LC-02s/CL70_Keyboard/Housing/References/TadPole_Mount_1.png

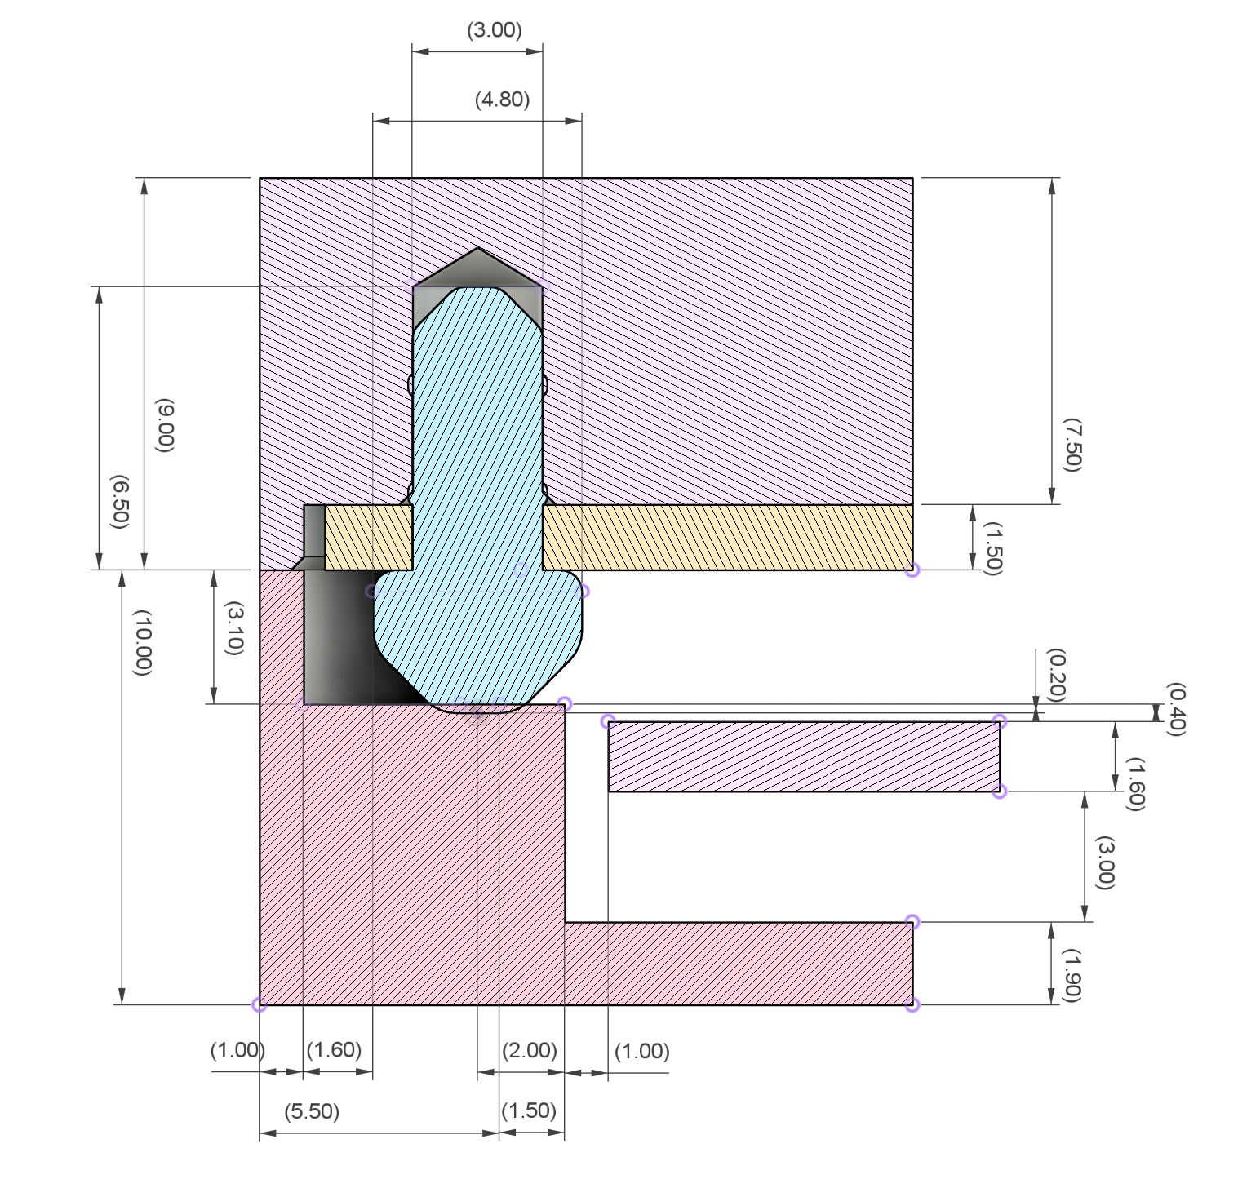
Housing/References/TadPole_Mount_1.png
