LC-02s/CL70_Keyboard/Layout/3u-split-layout.png

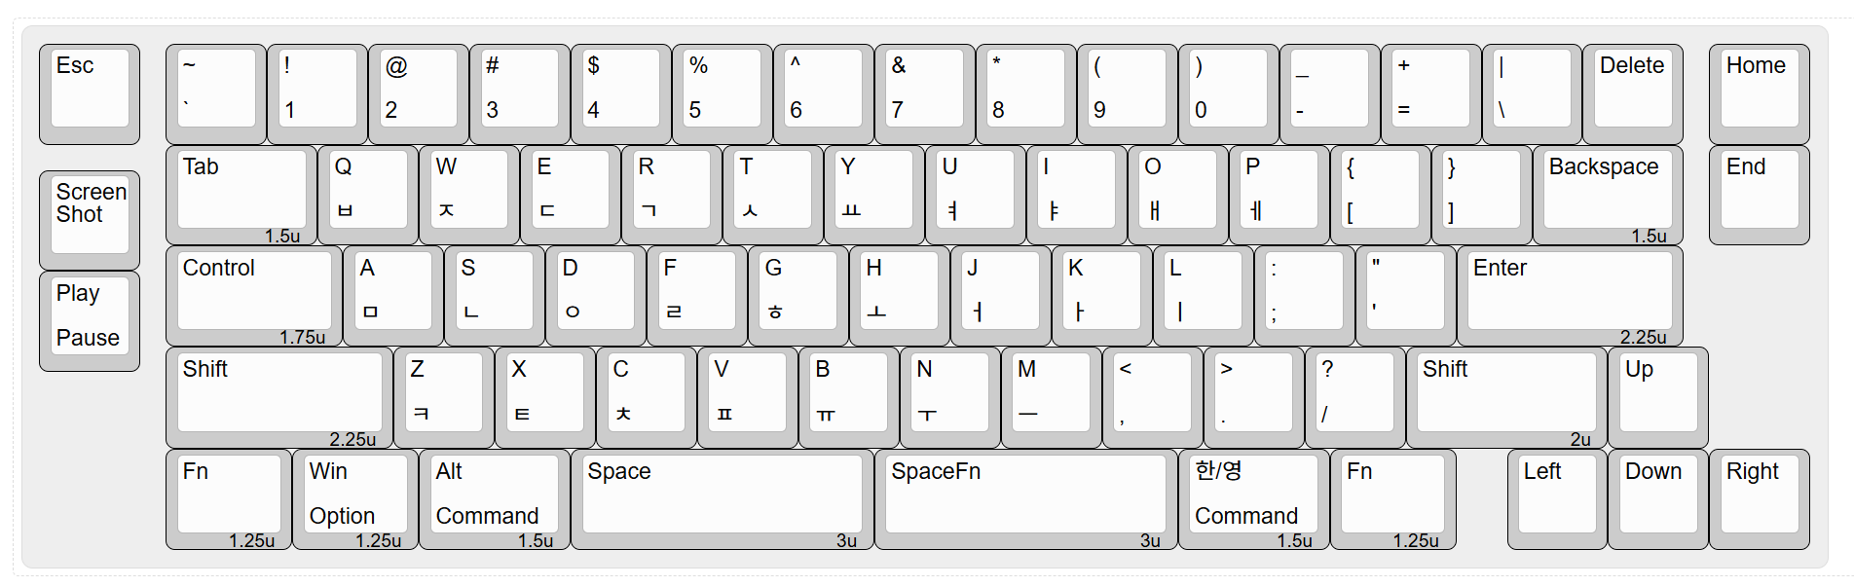
Layout/3u-split-layout.png
