LC-02s/CL70_Keyboard/Layout/6u-layout.png

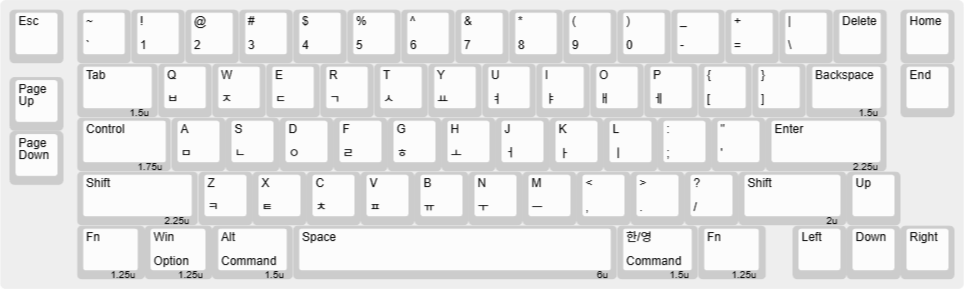
Layout/6u-layout.png
