LC-02s/CL70_Keyboard/Housing/CL70_BottomCase_V2_NonWeight.step

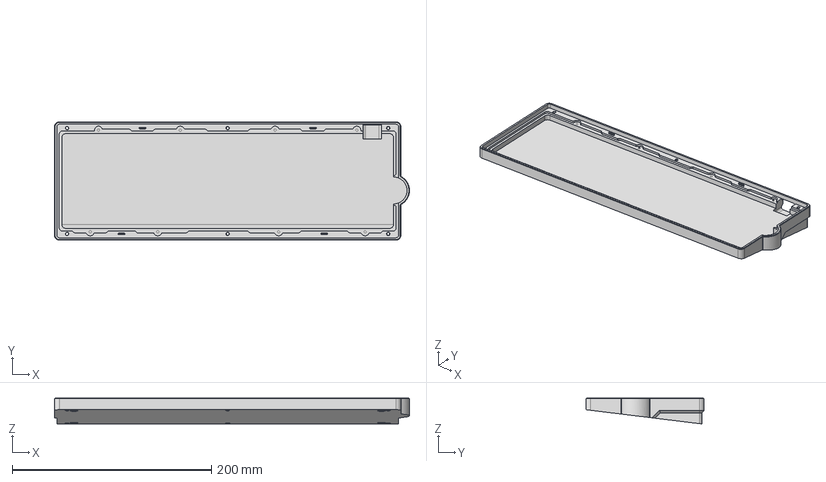
[picture p5: CAD file, 2025-09-10]
Housing/CL70_BottomCase_V2_NonWeight.step
356.7 x 118.9 x 26.0 mm
