LC-02s/CL70_Keyboard/PCB/Guide/PCB_GUIDELINE.dxf

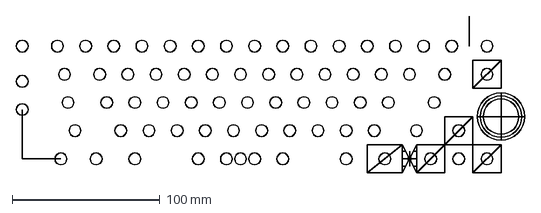
[picture p6: CAD file, 2025-09-10]
PCB/Guide/PCB_GUIDELINE.dxf
343.9 x 106.1 mm
