LC-02s/CL70_Keyboard/Plate/CL70_Plate_3u_Split.dxf

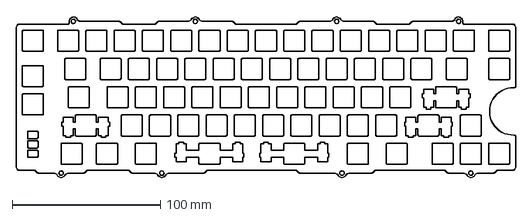
[picture p7: CAD file, 2025-09-10]
Plate/CL70_Plate_3u_Split.dxf
336.5 x 108.5 mm
