LC-02s/CL70_Keyboard/Housing/CL70_TopCase_V2_TappedHole.step

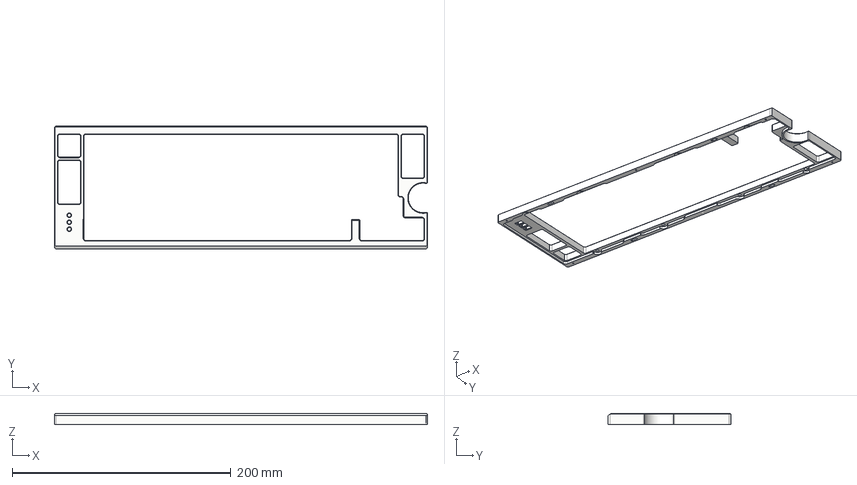
[picture p8: CAD file, 2025-09-10]
Housing/CL70_TopCase_V2_TappedHole.step
341.4 x 112.3 x 10.0 mm
