LC-02s/CL70_Keyboard/PCB/Guide/PCB_OUTLINE.dxf

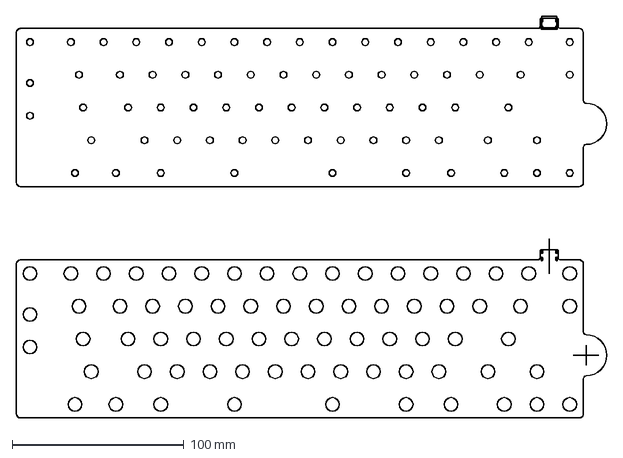
[picture p9: CAD file, 2025-09-10]
PCB/Guide/PCB_OUTLINE.dxf
343.8 x 234.1 mm
