LC-02s/CL70_Keyboard/Plate/CL70_Plate_6u.dxf

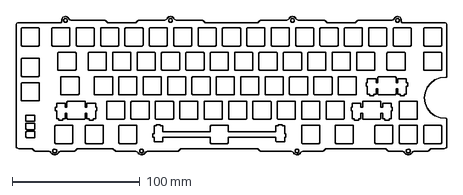
[picture p10: CAD file, 2025-09-10]
Plate/CL70_Plate_6u.dxf
336.5 x 108.5 mm
