LC-02s/CL70_Keyboard/(list of files, cad)

Other CAD files:
Housing/CL70_BottomCase_V2_InsertNuts.step
Housing/CL70_TopCase_V2.step
Housing/CL70_BottomCase_V2.step
Housing/References/FROG_TKL_PIN_TOP.f3d
Housing/References/SQUARE_ROUND_20mm_FEET.f3d
PCB/Guide/PCB_GUIDELINE.dwg
PCB/Guide/PCB_OUTLINE.dwg
Plate/CL70_Plate_3u_Split.dwg
Plate/CL70_Plate_6u.dwg
