LC-02s/CL70_Keyboard/PCB/CL70_PCB.kicad_pcb

## KiCad design PCB/CL70_PCB.kicad_pcb (2025-09-10)

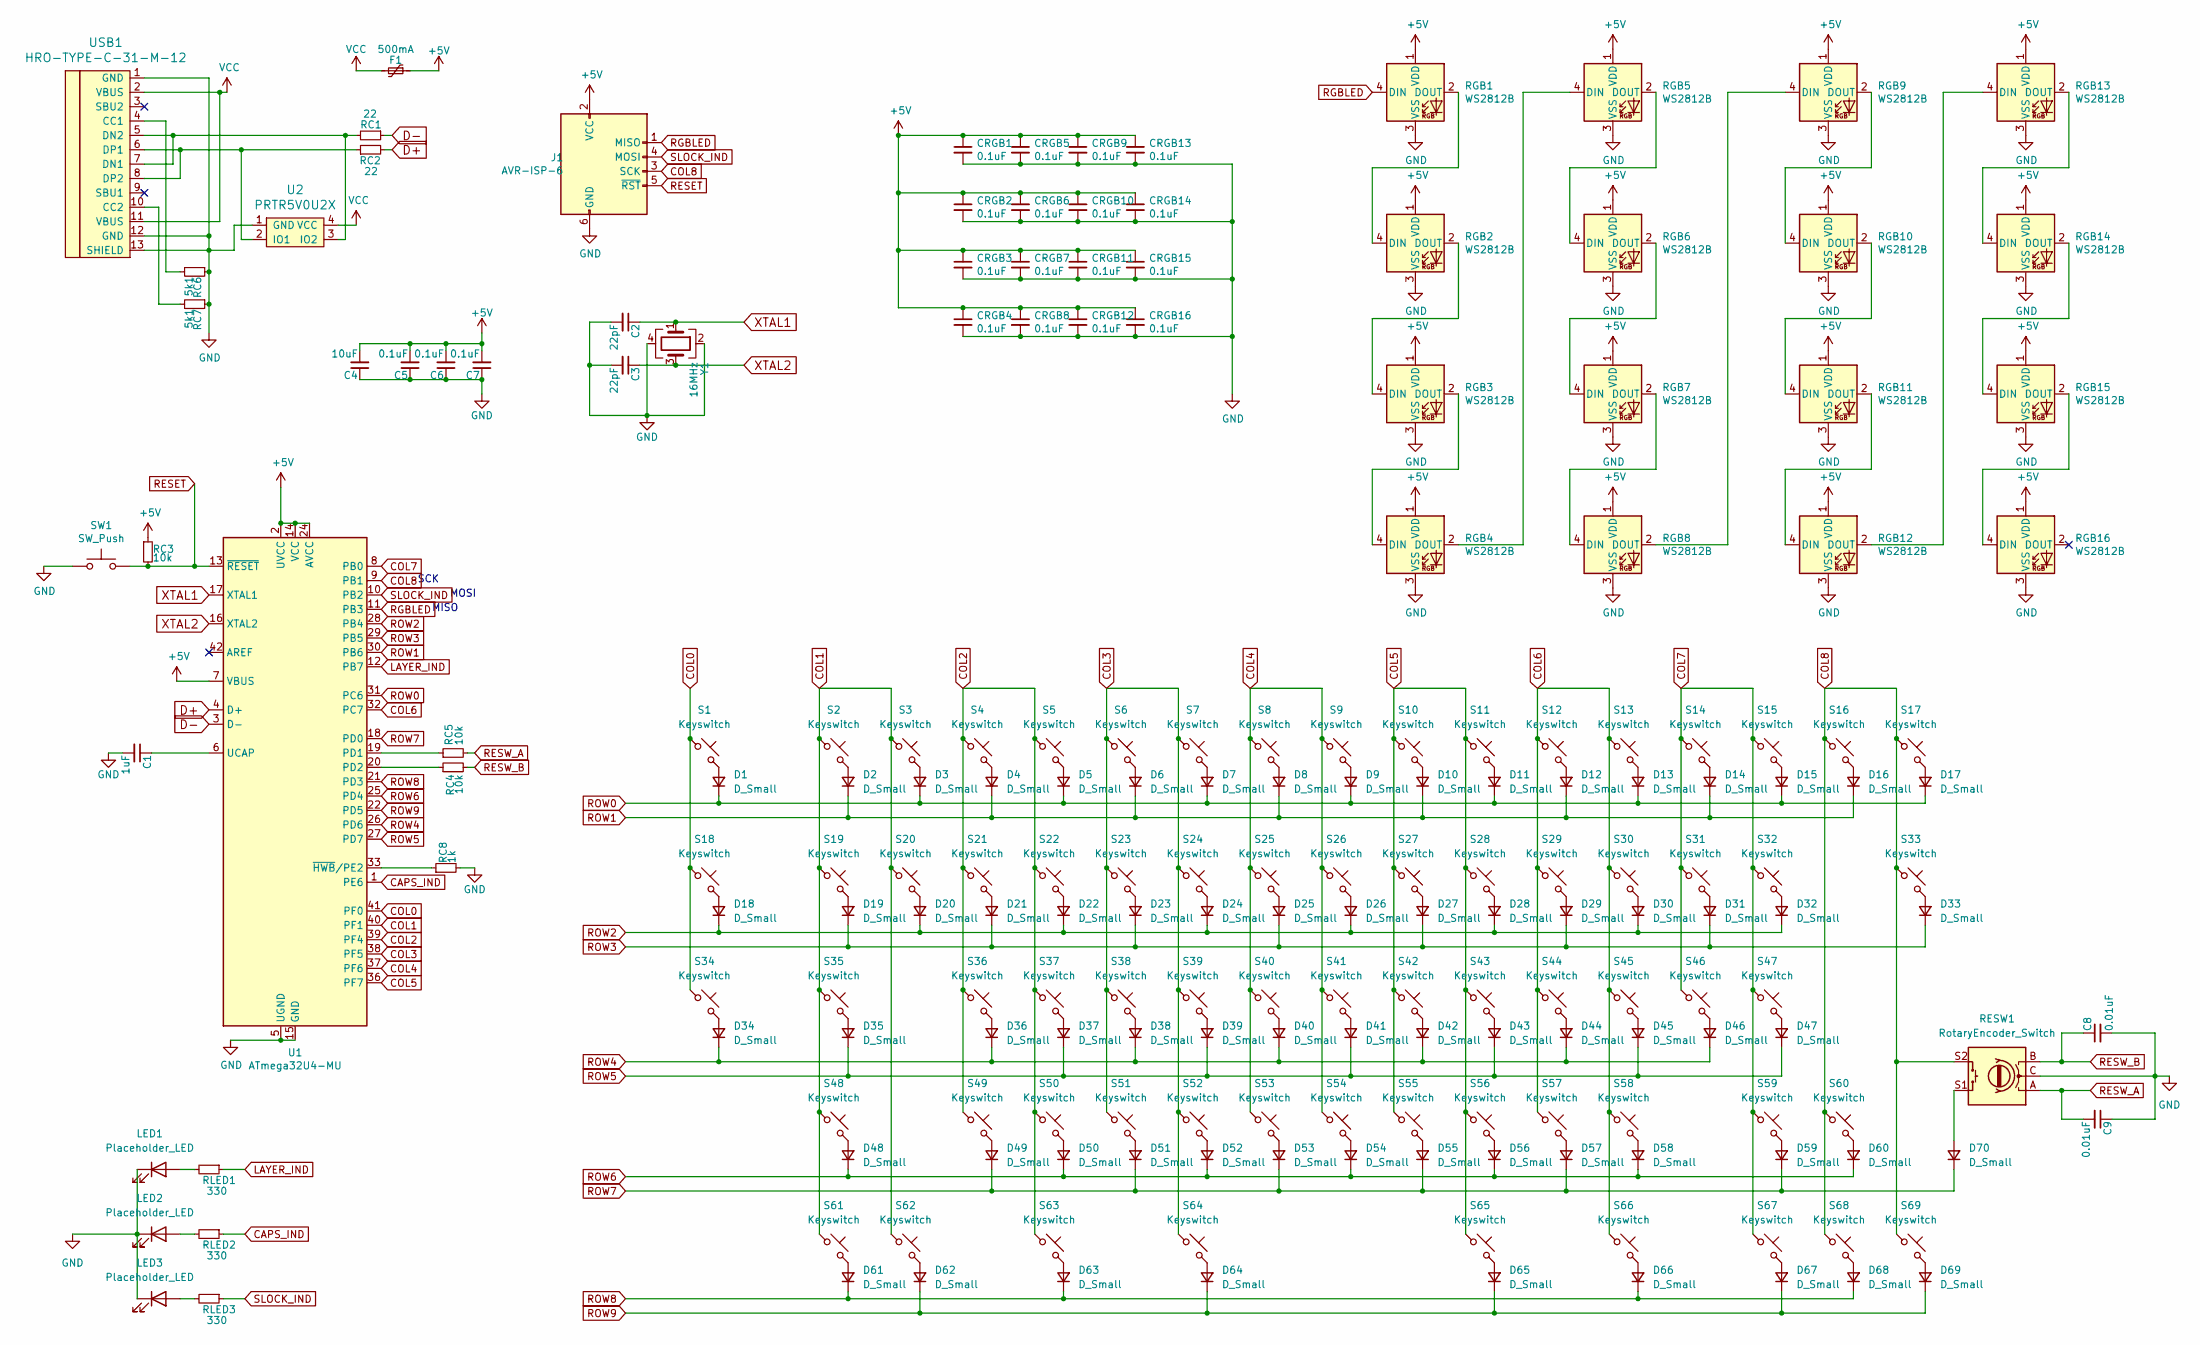
[picture p11: schematic CL70_PCB.kicad_sch]

Parts:
C1: 1uF; C_0603
C2, C3: 22pF; C_0603
C4: 10uF; C_0603
C5, C6, C7: 0.1uF; C_0603
C8, C9: 0.01uF; C_0603
CRGB1, CRGB2, CRGB3, CRGB4, CRGB5, CRGB6, CRGB7, CRGB8, CRGB9, CRGB10, CRGB11, CRGB12, CRGB13, CRGB14, CRGB15, CRGB16: 0.1uF; C_0603
D1, D2, D3, D4, D5, D6, D7, D8, D9, D10, D11, D12, D13, D14, D15, D16, D17, D18, D19, D20, D21, D22, D23, D24, D25, D26, D27, D28, D29, D30, D31, D32, D33, D34, D35, D36, D37, D38, D39, D40, D41, D42, D43, D44, D45, D46, D47, D48, D49, D50, D51, D52, D53, D54, D55, D56, D57, D58, D59, D60, D61, D62, D63, D64, D65, D66, D67, D68, D69, D70: D_Small; D_SOD-123
F1: 500mA; Fuse_1206_3216Metric
J1: AVR-ISP-6; Reset_Pretty-Mask
LED1, LED2, LED3: Placeholder_LED; LED_D3.0mm-Pretty
RC1, RC2: 22; R_0603
RC3, RC4, RC5: 10k; R_0603
RC6, RC7: 5k1; R_0603
RC8: 1k; R_0603
RESW1: RotaryEncoder_Switch; RotaryEncoder_Alps_EC11E-Switch_Vertical_H20mm
RGB1, RGB2, RGB3, RGB4, RGB5, RGB6, RGB7, RGB8, RGB9, RGB10, RGB11, RGB12, RGB13, RGB14, RGB15, RGB16: WS2812B; LED_WS2812B-PLCC4
RLED1, RLED2, RLED3: 330; R_0603
S1, S2, S3, S4, S5, S6, S7, S8, S9, S10, S11, S12, S13, S14, S15, S16, S17, S18, S20, S21, S22, S23, S24, S25, S26, S27, S28, S29, S30, S31, S33, S34, S36, S37, S38, S39, S40, S41, S42, S43, S44, S45, S46, S49, S50, S51, S52, S53, S54, S55, S56, S57, S58, S60, S67, S68, S69: Keyswitch; MX_PCB_1.00u
S19, S32, S63, S65: Keyswitch; MX_PCB_1.50u
S35: Keyswitch; MX_PCB_1.75u
S47, S48: Keyswitch; Hotswap_MX_2.25u
S59: Keyswitch; Hotswap_MX_2.00u
S61, S62, S66: Keyswitch; MX_PCB_1.25u
S64: Keyswitch; Hotswap_MX_3.00u
SW1: SW_Push; SKQG-1155865
U1: ATmega32U4-MU; QFN-44-1EP_7x7mm_Pitch0.5mm
U2: PRTR5V0U2X; SOT143B
USB1: HRO-TYPE-C-31-M-12; HRO-TYPE-C-31-M-12-Assembly
Y1: 16MHz; Crystal_SMD_3225-4Pin_3.2x2.5mm

Connections:
+5V: C4.2, C5.2, C6.2, C7.2, CRGB1.1, CRGB2.1, CRGB3.1, CRGB4.1, CRGB5.1, CRGB6.1, CRGB7.1, CRGB8.1, CRGB9.1, CRGB10.1, CRGB11.1, CRGB12.1, CRGB13.1, CRGB14.1, CRGB15.1, CRGB16.1, F1.1, J1.2 (VCC), RC3.1, RGB1.1 (VDD), RGB2.1 (VDD), RGB3.1 (VDD), RGB4.1 (VDD), RGB5.1 (VDD), RGB6.1 (VDD), RGB7.1 (VDD), RGB8.1 (VDD), RGB9.1 (VDD), RGB10.1 (VDD), RGB11.1 (VDD), RGB12.1 (VDD), RGB13.1 (VDD), RGB14.1 (VDD), RGB15.1 (VDD), RGB16.1 (VDD), U1.2 (UVCC), U1.7 (VBUS), U1.14 (VCC), U1.24 (AVCC), U1.34 (VCC), U1.44 (AVCC)
CAPS_IND: RLED2.1, U1.1 (PE6)
COL0: S1.1, S18.1, S34.1, U1.41 (PF0)
COL1: S2.1, S3.1, S19.1, S20.1, S35.1, S48.1, S61.1, S62.1, U1.40 (PF1)
COL2: S4.1, S5.1, S21.1, S22.1, S36.1, S37.1, S49.1, S50.1, S63.1, U1.39 (PF4)
COL3: S6.1, S7.1, S23.1, S24.1, S38.1, S39.1, S51.1, S52.1, S64.1, U1.38 (PF5)
COL4: S8.1, S9.1, S25.1, S26.1, S40.1, S41.1, S53.1, S54.1, U1.37 (PF6)
COL5: S10.1, S11.1, S27.1, S28.1, S42.1, S43.1, S55.1, S56.1, S65.1, U1.36 (PF7)
COL6: S12.1, S13.1, S29.1, S30.1, S44.1, S45.1, S57.1, S58.1, S66.1, U1.32 (PC7)
COL7: S14.1, S15.1, S31.1, S32.1, S46.1, S47.1, S59.1, S67.1, U1.8 (PB0)
COL8: J1.3 (SCK), RESW1.S2, S16.1, S17.1, S33.1, S60.1, S68.1, S69.1, U1.9 (PB1)
D+: RC2.2, U1.4 (D+)
D-: RC1.1, U1.3 (D-)
GND: C1.2, C2.2, C3.2, C4.1, C5.1, C6.1, C7.1, C8.2, C9.1, CRGB1.2, CRGB2.2, CRGB3.2, CRGB4.2, CRGB5.2, CRGB6.2, CRGB7.2, CRGB8.2, CRGB9.2, CRGB10.2, CRGB11.2, CRGB12.2, CRGB13.2, CRGB14.2, CRGB15.2, CRGB16.2, J1.6 (GND), LED1.1 (K), LED2.1 (K), LED3.1 (K), RC6.1, RC7.1, RC8.2, RESW1.C, RGB1.3 (VSS), RGB2.3 (VSS), RGB3.3 (VSS), RGB4.3 (VSS), RGB5.3 (VSS), RGB6.3 (VSS), RGB7.3 (VSS), RGB8.3 (VSS), RGB9.3 (VSS), RGB10.3 (VSS), RGB11.3 (VSS), RGB12.3 (VSS), RGB13.3 (VSS), RGB14.3 (VSS), RGB15.3 (VSS), RGB16.3 (VSS), SW1.1, U1.5 (UGND), U1.15 (GND), U1.23 (GND), U1.35 (GND), U1.43 (GND), U1.45 (GND), U2.1 (GND), USB1.1 (GND), USB1.12 (GND), USB1.13 (SHIELD), Y1.2, Y1.4
LAYER_IND: RLED1.1, U1.12 (PB7)
unnamed: D1.2 (A), S1.2
unnamed: D2.2 (A), S2.2
unnamed: D3.2 (A), S3.2
unnamed: D4.2 (A), S4.2
unnamed: D5.2 (A), S5.2
unnamed: D6.2 (A), S6.2
unnamed: D7.2 (A), S7.2
unnamed: D8.2 (A), S8.2
unnamed: D9.2 (A), S9.2
unnamed: D10.2 (A), S10.2
unnamed: D11.2 (A), S11.2
unnamed: D12.2 (A), S12.2
unnamed: D13.2 (A), S13.2
unnamed: D14.2 (A), S14.2
unnamed: D15.2 (A), S15.2
unnamed: D16.2 (A), S16.2
unnamed: D17.2 (A), S17.2
unnamed: D18.2 (A), S18.2
unnamed: D19.2 (A), S19.2
unnamed: D20.2 (A), S20.2
unnamed: D21.2 (A), S21.2
unnamed: D22.2 (A), S22.2
unnamed: D23.2 (A), S23.2
unnamed: D24.2 (A), S24.2
unnamed: D25.2 (A), S25.2
unnamed: D26.2 (A), S26.2
unnamed: D27.2 (A), S27.2
unnamed: D28.2 (A), S28.2
unnamed: D29.2 (A), S29.2
unnamed: D30.2 (A), S30.2
unnamed: D31.2 (A), S31.2
unnamed: D32.2 (A), S32.2
unnamed: D33.2 (A), S33.2
unnamed: D34.2 (A), S34.2
unnamed: D35.2 (A), S35.2
unnamed: D36.2 (A), S36.2
unnamed: D37.2 (A), S37.2
unnamed: D38.2 (A), S38.2
unnamed: D39.2 (A), S39.2
unnamed: D40.2 (A), S40.2
unnamed: D41.2 (A), S41.2
unnamed: D42.2 (A), S42.2
unnamed: D43.2 (A), S43.2
unnamed: D44.2 (A), S44.2
unnamed: D45.2 (A), S45.2
unnamed: D46.2 (A), S46.2
unnamed: D47.2 (A), S47.2
unnamed: D48.2 (A), S48.2
unnamed: D49.2 (A), S49.2
unnamed: D50.2 (A), S50.2
unnamed: D51.2 (A), S51.2
unnamed: D52.2 (A), S52.2
unnamed: D53.2 (A), S53.2
unnamed: D54.2 (A), S54.2
unnamed: D55.2 (A), S55.2
unnamed: D56.2 (A), S56.2
unnamed: D57.2 (A), S57.2
unnamed: D58.2 (A), S58.2
unnamed: D59.2 (A), S59.2
unnamed: D60.2 (A), S60.2
unnamed: D61.2 (A), S61.2
unnamed: D62.2 (A), S62.2
unnamed: D63.2 (A), S63.2
unnamed: D64.2 (A), S64.2
unnamed: D65.2 (A), S65.2
unnamed: D66.2 (A), S66.2
unnamed: D67.2 (A), S67.2
unnamed: D68.2 (A), S68.2
unnamed: D69.2 (A), S69.2
unnamed: D70.2 (A), RESW1.S1
unnamed: LED1.2 (A), RLED1.2
unnamed: LED2.2 (A), RLED2.2
unnamed: LED3.2 (A), RLED3.2
unnamed: RGB1.2 (DOUT), RGB2.4 (DIN)
unnamed: RGB2.2 (DOUT), RGB3.4 (DIN)
unnamed: RGB3.2 (DOUT), RGB4.4 (DIN)
unnamed: RGB4.2 (DOUT), RGB5.4 (DIN)
unnamed: RGB5.2 (DOUT), RGB6.4 (DIN)
unnamed: RGB6.2 (DOUT), RGB7.4 (DIN)
unnamed: RGB7.2 (DOUT), RGB8.4 (DIN)
unnamed: RGB8.2 (DOUT), RGB9.4 (DIN)
unnamed: RGB9.2 (DOUT), RGB10.4 (DIN)
unnamed: RGB10.2 (DOUT), RGB11.4 (DIN)
unnamed: RGB11.2 (DOUT), RGB12.4 (DIN)
unnamed: RGB12.2 (DOUT), RGB13.4 (DIN)
unnamed: RGB13.2 (DOUT), RGB14.4 (DIN)
unnamed: RGB14.2 (DOUT), RGB15.4 (DIN)
unnamed: RGB15.2 (DOUT), RGB16.4 (DIN)
unnamed: RC5.1, U1.19 (PD1)
unnamed: RC4.1, U1.20 (PD2)
unnamed: C1.1, U1.6 (UCAP)
unnamed: RC8.1, U1.33 (~HWB/PE2)
unnamed: RC2.1, U2.2 (IO1), USB1.6 (DP1), USB1.8 (DP2)
unnamed: RC1.2, U2.3 (IO2), USB1.5 (DN2), USB1.7 (DN1)
unnamed: RC6.2, USB1.4 (CC1)
unnamed: RC7.2, USB1.10 (CC2)
RESET: J1.5 (~RST), RC3.2, SW1.2, U1.13 (~RESET)
RESW_A: C9.2, RC5.2, RESW1.A
RESW_B: C8.1, RC4.2, RESW1.B
RGBLED: J1.1 (MISO), RGB1.4 (DIN), U1.11 (PB3)
ROW0: D1.1 (K), D3.1 (K), D5.1 (K), D7.1 (K), D9.1 (K), D11.1 (K), D13.1 (K), D15.1 (K), D17.1 (K), U1.31 (PC6)
ROW1: D2.1 (K), D4.1 (K), D6.1 (K), D8.1 (K), D10.1 (K), D12.1 (K), D14.1 (K), D16.1 (K), U1.30 (PB6)
ROW2: D18.1 (K), D20.1 (K), D22.1 (K), D24.1 (K), D26.1 (K), D28.1 (K), D30.1 (K), D32.1 (K), U1.28 (PB4)
ROW3: D19.1 (K), D21.1 (K), D23.1 (K), D25.1 (K), D27.1 (K), D29.1 (K), D31.1 (K), D33.1 (K), U1.29 (PB5)
ROW4: D34.1 (K), D36.1 (K), D38.1 (K), D40.1 (K), D42.1 (K), D44.1 (K), D46.1 (K), U1.26 (PD6)
ROW5: D35.1 (K), D37.1 (K), D39.1 (K), D41.1 (K), D43.1 (K), D45.1 (K), D47.1 (K), U1.27 (PD7)
ROW6: D48.1 (K), D50.1 (K), D52.1 (K), D54.1 (K), D56.1 (K), D58.1 (K), D60.1 (K), U1.25 (PD4)
ROW7: D49.1 (K), D51.1 (K), D53.1 (K), D55.1 (K), D57.1 (K), D59.1 (K), D70.1 (K), U1.18 (PD0)
ROW8: D61.1 (K), D63.1 (K), D66.1 (K), D68.1 (K), U1.21 (PD3)
ROW9: D62.1 (K), D64.1 (K), D65.1 (K), D67.1 (K), D69.1 (K), U1.22 (PD5)
SLOCK_IND: J1.4 (MOSI), RLED3.1, U1.10 (PB2)
VCC: F1.2, U2.4 (VCC), USB1.2 (VBUS), USB1.11 (VBUS)
XTAL1: C2.1, U1.17 (XTAL1), Y1.1
XTAL2: C3.1, U1.16 (XTAL2), Y1.3

Notes on the sheet:
SCK
MISO
MOSI

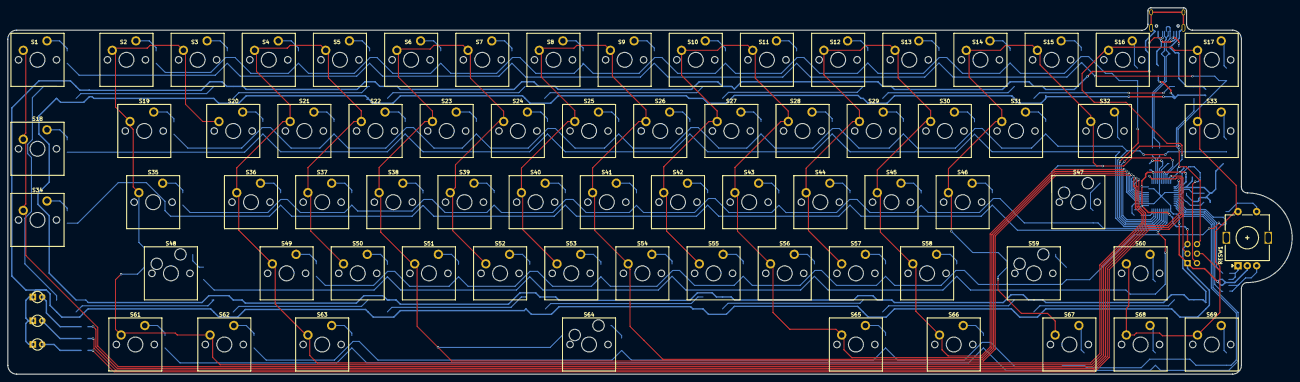
[picture p12: board CL70_PCB.kicad_pcb from above]

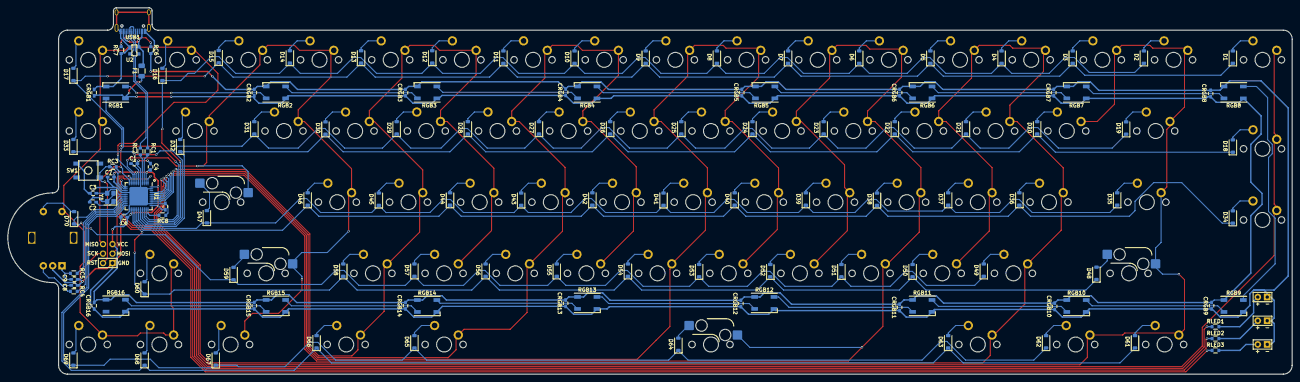
[picture p13: board CL70_PCB.kicad_pcb from below]

Board: 2 copper layers, 343.8 x 98.1 mm, 202 parts (129 on the bottom side), 129 nets.
