LC-02s/CL70_Keyboard/(commit log)

2025-07-25 Realignment footprint
    [CL70_PCB.kicad_pcb]
2025-07-26 Add PCB outline
    [CL70_PCB.kicad_pcb, PCB_OUTLINE.dwg, PCB_OUTLINE.dxf]
2025-07-27 Add wiring
    [CL70_PCB.kicad_pcb, CL70_PCB.kicad_sch]
2025-07-28 Add graphic sorder mask
    [CL70_PCB.kicad_pcb, PCB_GUIDELINE.dwg, PCB_GUIDELINE.dxf]
2025-08-04 Add production files
    [CL70_PCB-B_Cu.gbr, CL70_PCB-B_Mask.gbr, CL70_PCB-B_Paste.gbr, CL70_PCB-B_Silkscreen.gbr, CL70_PCB-Edge_Cuts.gbr, CL70_PCB-F_Cu.gbr, CL70_PCB-F_Mask.gbr, CL70_PCB-F_Paste.gbr]
2025-08-12 Update PCB Outline
    [PCB_OUTLINE.dwg, PCB_OUTLINE.dxf]
2025-09-10 Update Rev 1.1
    [CL70_PCB-B_Cu.gbr, CL70_PCB-B_Mask.gbr, CL70_PCB-B_Paste.gbr, CL70_PCB-B_Silkscreen.gbr, CL70_PCB-Edge_Cuts.gbr, CL70_PCB-F_Cu.gbr, CL70_PCB-F_Mask.gbr, CL70_PCB-F_Paste.gbr]
2025-09-10 Add housing files
    [CL70_BottomCase_V2.step, CL70_BottomCase_V2_InsertNuts.step, CL70_BottomCase_V2_NonWeight.step, CL70_TopCase_V2.step, CL70_TopCase_V2_TappedHole.step, FROG_TKL_PIN_TOP.f3d, SQUARE_ROUND_20mm_FEET.f3d]
2025-09-10 Add plate files
    [CL70_Plate_3u_Split.dwg, CL70_Plate_3u_Split.dxf, CL70_Plate_6u.dwg, CL70_Plate_6u.dxf]
